howtokap/kap-tx1/README.md

An Arduino-based R/C transmitter for Kite Aerial Photography.

Design documentation can be found in doc/KAP RC Arduino.pdf

Discussion of this project hosted at [the KAP Forum](http://arch.ced.berkeley.edu/kap/discuss/index.php?p=/discussion/5325/repackaged-r-c-arduino-kap-controller)
