howtokap/kap-tx1/bezel/bezel.stl

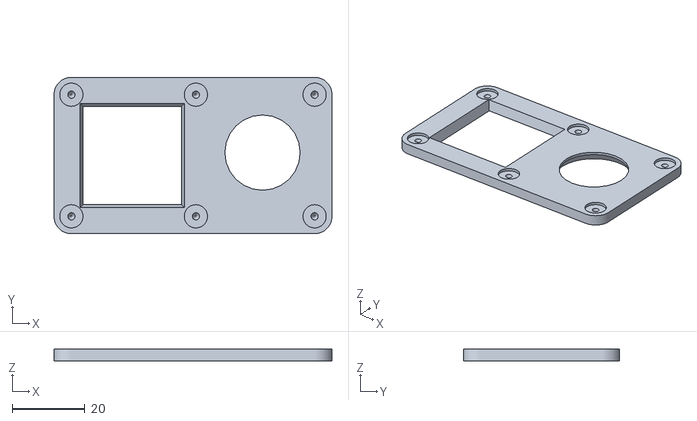
[picture p10: CAD file, 2015-03-17]
bezel/bezel.stl
76.2 x 42.9 x 3.17
