howtokap/kap-tx1/Arduino/kaptx/KapTxLcd.h

#pragma once


class KapTxModel;

class KapTxLcd
{
  public:
  KapTxLcd(KapTxModel *model);

  private:
    // Instance data
    // Adafruit_SharpMem display;
    KapTxModel *model;
/*    TODO-DW : remove
    unsigned char flags;
    signed char pan;  // 0-23
    signed char tilt; // -3 - 8
    unsigned char shots;
    unsigned char shootMode;
    unsigned char shutterState;
    unsigned char shutterStateLcd;
    bool vertical;
    bool autokap;
    bool priorityRefresh;
*/
    unsigned char sinceRefresh;
    bool refreshNeeded;

  public:
    // Public API
    void setup();
    void update();

  private:
    // Utility methods
    void showBitmap(unsigned char bitmapId, unsigned char color);
    void showShutter(unsigned char state);   // based on showShutter
    void showShootMode(unsigned char mode, bool inv);  // based on showShootMode
    void showShots(bool autokap, int shots, bool inv);               // based on showShots
    void showHoVer(bool vertical, bool inv);           // based on showHoVer
    void showPan(int pan);
    void showTilt(int tilt);
    void drawUpdates(unsigned char flags);
};
