howtokap/kap-tx1/(commit log)

2015-02-04 Adding initial files.
    kaptx.ino is feature-complete transmitter firmware.
    ppm_gen.ino is the PPM testbed sketch.
    KAP RC Arduino.pdf is the write-up not updated to reflect LCD.
2015-02-09 Fixed comments, added description of the sketch and how to use it.
    [ppm_gen.ino]
2015-02-21 Putting bezel files into Git.
    [bezel.scad, bezel.stl]
2015-03-17 Bug fixes in code and documentation.
    Joystick params changed to make it easier to "hit" mode change corners.
    Cluster mode - fixed bug with tilt index computation under/overflow.
    Cluster mode - changed pan/tilt sequence in mid-tilt range.
    Doc - Fixed reversed D8/D9 in Table 15.
    Doc - Added note on photo: bind signal should be connected to Arduino.
    [kaptx.ino]
2015-04-02 Corrected problem where display was rotated 180 degrees.
    This problem was introduced by changes to the SHARP LCD driver. An extraneous
    call to setRotation(2) is in the begin method but the logic to actually
    implement screen rotations wasn't implemented. Later it was implemented and the
    setRotation(2) had the effect of rotating the display. As a workaround, I now
    call setRotation(0) just after display.begin().
    [kaptx.ino]
2015-04-21 Replace panTable, tiltTable with parameters.
    Added instructions on tuning pan and tilt, too.
    [kaptx.ino]
2015-10-06 Fixed bug: #ifdef 0 needs to be #if 0.
    [kaptx.ino]
2016-02-26 Fixed bug where PPM signal was missing channels.
    Problem seemed to be a compiler bug of some sort? In Ppm::setup(), the
    array _ppm.time[] was being initialized but the loop would exit before
    all entries were set. The result was some channels had 0 length, which
    caused skipped pulses.
    The code was very sensitive to debugging attempts. Adding certain code
    inside that loop would change the behavior to make it work properly.
    [Ppm.cpp]
2016-03-06 Fixing PPM Generation bug. (Again!)
    [Ppm.cpp]
2016-03-08 Fixed bug where PPM was set up for 8MHz instead of 16MHz.
    Also added testing of channel 6 by duplicating the tilt output.
    [Ppm.cpp, kaptx.ino]
2016-03-20 Big cleanup: fixed shutter servo range bug, creating Tuning.h file.
    [Controller.cpp, Controller.h, Joystick.cpp, Joystick.h, Model.cpp, Model.h, Ppm.h, Tuning.h]
